DK0FR/rs485-protection-module/Mouser-Bestellliste-Rotor-Schutzmodul (1).xlsx

Sheet: Mouser
Mfr Part Number | Quantity | Manufacturer | Reference | Description | Nummer geprüft
2631803802 | 2 | Fair-Rite | FK1 | Ringkern Material 31, Ø 61 mm (FT240-31), außen auf der Steuerleitung; 1 Motorseite + 1 Stationsseite | nein
MF-R800 | 2 | Bourns | F1 | PTC-Sicherung, selbstrückstellend, 8 A halten / 16 A auslösen, 30 V, Raster 10,2 mm, 33 mm hoch; 1 Reserve | ja
B72214S0300K101 | 1 | TDK | RV1 | Varistor S14K30, 30 V AC / 38 V DC, bedrahtet | ja
2035-09-SM-RPLF | 1 | Bourns | GDT1 | Gasableiter 90 V, 2 Elektroden, 5 kA, SMD | ja
C1206C103KDRACTU | 8 | KEMET | C5–C10 | 10 nF, 1 kV, X7R, 1206; 2 Reserve | ja
744824801 | 1 | Würth Elektronik | L1 | Gleichtaktdrossel WE-CMB, 1 mH, 7,5 A, bedrahtet | ja
744842632 | 1 | Würth Elektronik | L2 | Gleichtaktdrossel WE-CMBNiZn, 32 µH, 5,5 A, bedrahtet | ja
SMCJ26A | 1 | Littelfuse | D1 | TVS 26 V, 1500 W, unidirektional, SMC | nein
EEU-FC1J101 | 1 | Panasonic | C1 | Elko 100 µF, 63 V, low ESR, bedrahtet | ja
C1206C104K1RACTU | 2 | KEMET | C2 | 100 nF, 100 V, X7R, 1206; 1 Reserve | nein
SMBJ15CA | 1 | Littelfuse | D3 | TVS 15 V, 600 W, bidirektional, SMB | nein
RC1206FR-071ML | 2 | Yageo | R4 | 1 MΩ, 1 %, 1206; 1 Reserve | nein
C1206C102JDGACTU | 6 | KEMET | C3, C4, C11, C12 | 1 nF, 1 kV, C0G, 5 %, 1206; 2 Reserve | ja
2036-09-SM-RPLF | 1 | Bourns | GDT2 | Gasableiter 90 V, 3 Elektroden, SMD | ja
CMB02070X1009JB200 | 4 | Vishay | R1, R2 | 10 Ω, Kohleschicht-MELF 0207, impulsfest; 2 Reserve | ja
744272222 | 1 | Würth Elektronik | L3 | Gleichtaktdrossel WE-SL5, 2,2 mH, 750 mA, SMD | ja
744227 | 1 | Würth Elektronik | L4 | Gleichtaktdrossel WE-SL2, 51 µH, SMD | ja
SM712.TCT | 2 | Semtech | D2 | TVS-Array RS485, 7 V / 12 V, SOT-23; 1 Reserve | ja
RC1206FR-07120RL | 2 | Yageo | R3 | 120 Ω, 1 %, 1206; 1 Reserve | nein
61300211121 | 1 | Würth Elektronik | JP1 | Stiftleiste 2-polig, Raster 2,54 mm | nein
60900213421 | 1 | Würth Elektronik | JP1 | Steckbrücke 2,54 mm | nein
1715721 | 3 | Phoenix Contact | J1, J2, J3 | Schraubklemme MKDS 1,5/2-5,08, 2-polig | nein
1715734 | 1 | Phoenix Contact | J4 | Schraubklemme MKDS 1,5/3-5,08, 3-polig | ja

Sheet: Hinweise
Bestellliste Rotor-Schutzmodul RS485 / 24 V, Rev. 4, Stand 11.10.2026
Blatt "Mouser": Spalte A = Hersteller-Bestellnummer, Spalte B = Menge. Diese beiden Spalten beim BOM-Import zuordnen.
Mengen: ein Modul, bei Kleinteilen mit Reserve (steht in der Beschreibung). FK1 zweimal: ein Ringkern am Motor, einer an der Station.
Nummer geprüft = ja: Bestellnummer am 08.10.2026 in einer Distributor-Liste gefunden. nein: aus dem Gedächtnis, nicht nachgeschlagen.
Lagerbestand, Preise und Mindestmengen bei Mouser wurden nicht geprüft.
Rev. 3: F1 ist jetzt eine selbstrückstellende PTC-Sicherung (Bourns MF-R800) statt Feinsicherung mit Halter.
Ersatz für C1206C102JDGACTU, falls nicht lieferbar: Yageo CC1206JKNPOCBN102 (1 nF, 1 kV, NP0, 5 %, 1206).
Rev. 4: Die Adapterplatine PA0086 entfällt, D2 sitzt direkt auf der Leiterplatte. Nicht in der Liste: Hirschmann CA 6 GD, Abstandshalter M3 x 5 mm, Leiterplatte.
C3 und C4 sind mit dem 1-kV-Typ von C11/C12 zusammengelegt, das spart eine Bestellposition.
