DK0FR/rs485-protection-module/doc/schaltplan.pdf

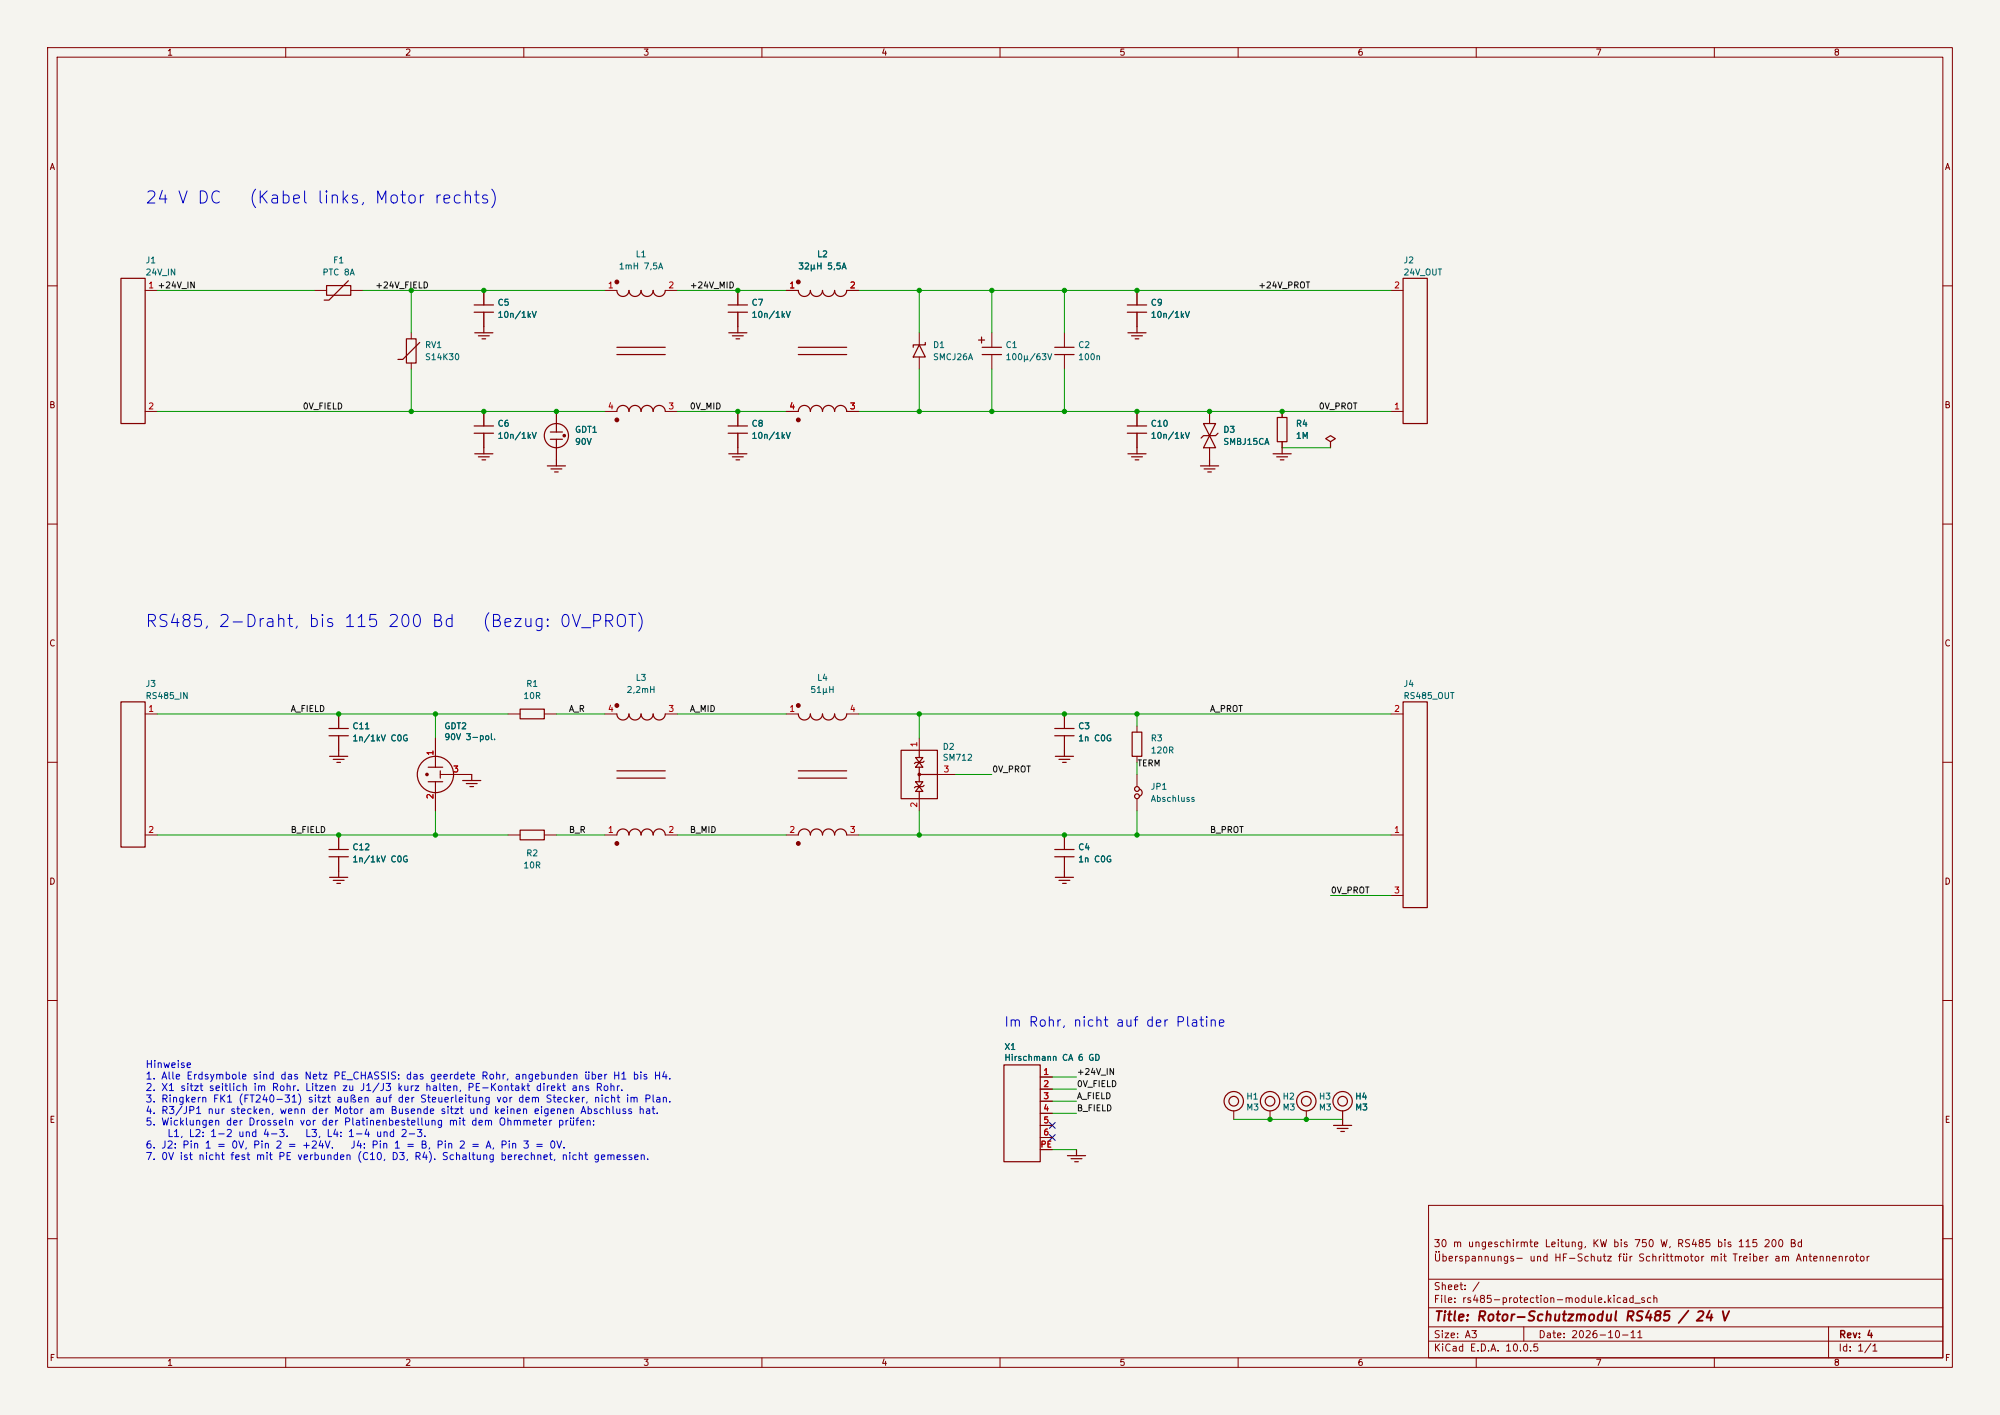
[picture p9: page 1]

Im Rohr, nicht auf der Platine

Hinweise
1. Alle Erdsymbole sind das Netz PE_CHASSIS: das geerdete Rohr, angebunden über H1 bis H4.
2. X1 sitzt seitlich im Rohr. Litzen zu J1/J3 kurz halten, PE-Kontakt direkt ans Rohr.
3. Ringkern FK1 (FT240-31) sitzt außen auf der Steuerleitung vor dem Stecker, nicht im Plan.
4. R3/JP1 nur stecken, wenn der Motor am Busende sitzt und keinen eigenen Abschluss hat.
5. Wicklungen der Drosseln vor der Platinenbestellung mit dem Ohmmeter prüfen:
7. 0V ist nicht fest mit PE verbunden (C10, D3, R4). Schaltung berechnet, nicht gemessen.

30 m ungeschirmte Leitung, KW bis 750 W, RS485 bis 115 200 Bd
Überspannungs- und HF-Schutz für Schrittmotor mit Treiber am Antennenrotor

Size: A3 | Rev: 4 | F Date: 2026-10-11
KiCad E.D.A. 10.0.5 | Id: 1/1
