DK0FR/rs485-protection-module/rs485-protection-module.kicad_pcb

## KiCad design rs485-protection-module.kicad_pcb (2026-10-15)

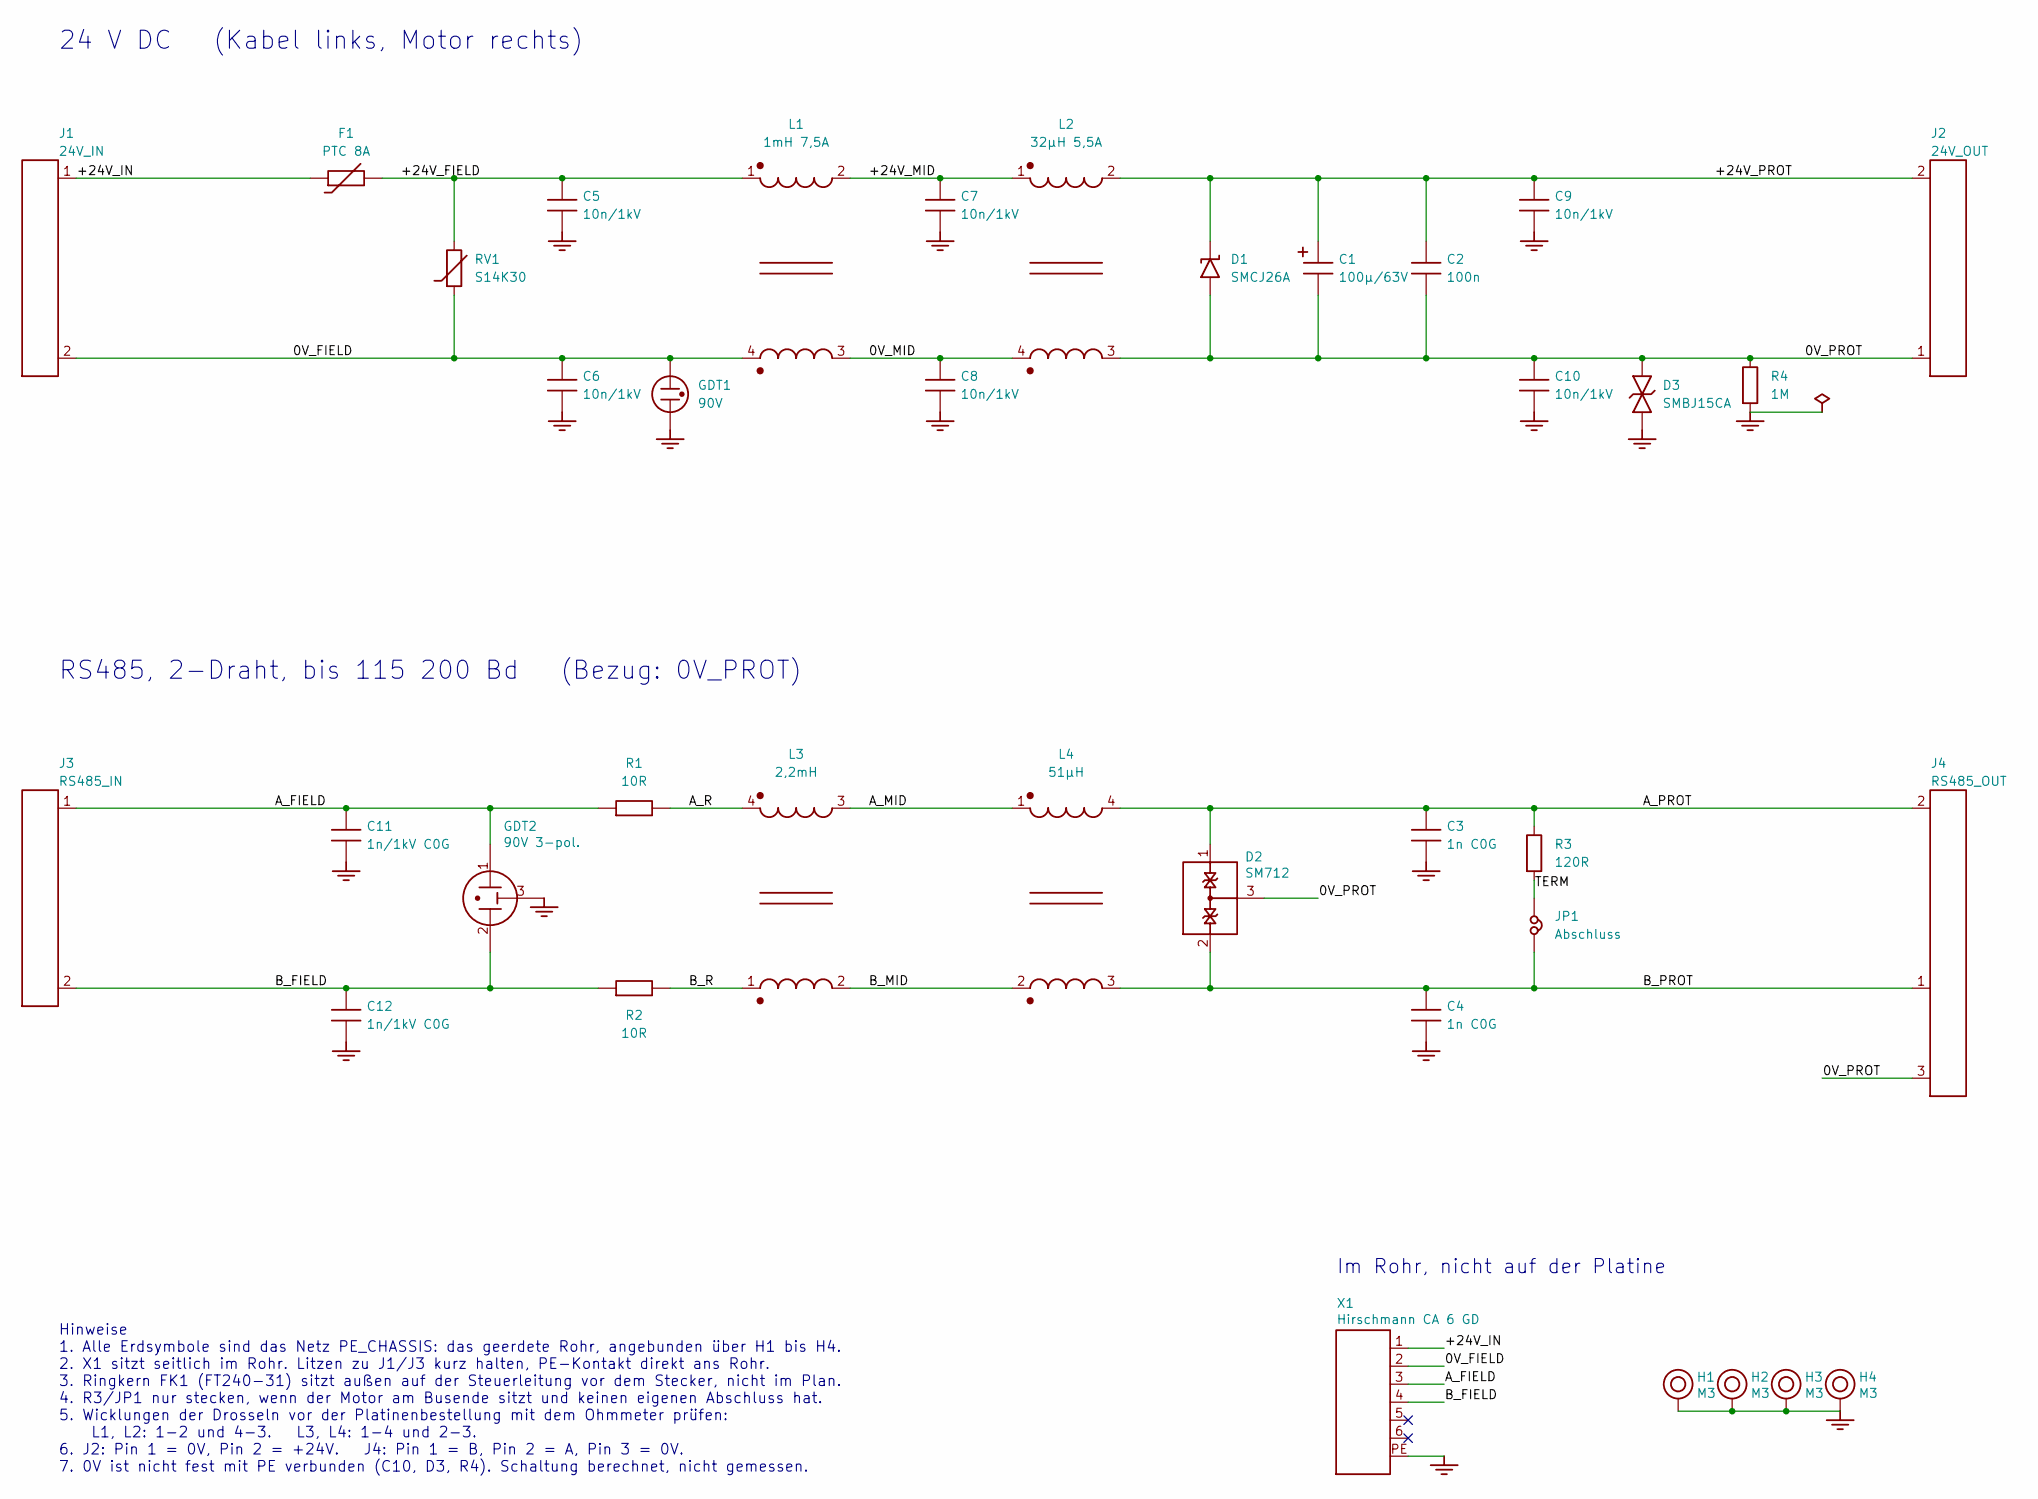
[picture p10: schematic rs485-protection-module.kicad_sch, Rotor-Schutzmodul RS485 / 24 V]

Parts:
C1: 100µ/63V; CP_Radial_D10.0mm_P5.00mm; MPN EEU-FC1J101
C2: 100n; C_1206_3216Metric_Pad1.33x1.80mm_HandSolder; MPN C1206C104K1RACTU
C3, C4: 1n C0G; C_1206_3216Metric_Pad1.33x1.80mm_HandSolder; MPN C1206C102JDGACTU
C5, C6, C7, C8, C9, C10: 10n/1kV; C_1206_3216Metric_Pad1.33x1.80mm_HandSolder; MPN C1206C103KDRACTU
C11, C12: 1n/1kV C0G; C_1206_3216Metric_Pad1.33x1.80mm_HandSolder; MPN C1206C102JDGACTU
D1: SMCJ26A; D_SMC_Handsoldering; MPN SMCJ26A
D2: SM712; SOT-23_Handsoldering; MPN SM712.TCT
D3: SMBJ15CA; D_SMB_Handsoldering; MPN SMBJ15CA
F1: PTC 8A; Fuse_PTC_Radial_P5.1mm_P10.2mm; MPN MF-R800
GDT1: 90V; GDT_Bourns_2035-xx-SM; MPN 2035-09-SM-RPLF
GDT2: 90V 3-pol.; GDT_Bourns_2036-xx-SM; MPN 2036-09-SM-RPLF
H1, H2, H3, H4: M3; MountingHole_3.2mm_M3_DIN965_Pad
J1: 24V_IN; TerminalBlock_Phoenix_MKDS-1,5-2-5.08_1x02_P5.08mm_Horizont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; MPN 1715721
J2: 24V_OUT; TerminalBlock_Phoenix_MKDS-1,5-2-5.08_1x02_P5.08mm_Horizont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; MPN 1715721
J3: RS485_IN; TerminalBlock_Phoenix_MKDS-1,5-2-5.08_1x02_P5.08mm_Horizont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; MPN 1715721
J4: RS485_OUT; TerminalBlock_Phoenix_MKDS-1,5-3-5.08_1x03_P5.08mm_Horizont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; MPN 1715734
JP1: Abschluss; PinHeader_1x02_P2.54mm_Vertical; MPN 60900213421
L1: 1mH 7,5A; L_CommonMode_Wuerth_WE-CMB-L_Pins1234; MPN 744824801
L2: 32µH 5,5A; L_CommonMode_Wuerth_WE-CMB-S; MPN 744842632
L3: 2,2mH; L_CommonModeChoke_Wuerth_WE-SL5; MPN 744272222
L4: 51µH; L_CommonMode_Wuerth_WE-SL2; MPN 744227
R1, R2: 10R; R_MELF_MMB-0207; MPN CMB02070X1009JB200
R3: 120R; R_1206_3216Metric_Pad1.30x1.75mm_HandSolder; MPN RC1206FR-07120RL
R4: 1M; R_1206_3216Metric_Pad1.30x1.75mm_HandSolder; MPN RC1206FR-071ML
RV1: S14K30; RV_Disc_D15.5mm_W4.5mm_P7.5mm; MPN B72214S0300K101
X1: Hirschmann CA 6 GD

Connections:
0V_FIELD: C6.1, GDT1.1, J1.2, L1.4, RV1.2, X1.2
0V_MID: C8.1, L1.3, L2.4
0V_PROT: C1.2, C2.2, C10.1, D1.2, D2.3, D3.1, J2.1, J4.3, L2.3, R4.1
+24V_FIELD: C5.1, F1.2, L1.1, RV1.1
+24V_IN: F1.1, J1.1, X1.1
+24V_MID: C7.1, L1.2, L2.1
+24V_PROT: C1.1, C2.1, C9.1, D1.1, J2.2, L2.2
A_FIELD: C11.1, GDT2.1, J3.1, R1.1, X1.3
A_MID: L3.3, L4.1
A_PROT: C3.1, D2.1, J4.2, L4.4, R3.1
A_R: L3.4, R1.2
B_FIELD: C12.1, GDT2.2, J3.2, R2.1, X1.4
B_MID: L3.2, L4.2
B_PROT: C4.1, D2.2, J4.1, JP1.2, L4.3
B_R: L3.1, R2.2
PE_CHASSIS: C3.2, C4.2, C5.2, C6.2, C7.2, C8.2, C9.2, C10.2, C11.2, C12.2, D3.2, GDT1.2, GDT2.3, H1.1, H2.1, H3.1, H4.1, R4.2, X1.PE
TERM: JP1.1, R3.2

Notes on the sheet:
Hinweise 1. Alle Erdsymbole sind das Netz PE_CHASSIS: das geerdete Rohr, angebunden über H1 bis H4. 2. X1 sitzt seitlich im Rohr. Litzen zu J1/J3 kurz halten, PE-Kontakt direkt ans Rohr. 3. Ringkern FK1 (FT240-31) sitzt außen auf der Steuerleitung vor dem Stecker, nicht im Plan. 4. R3/JP1 nur steck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
RS485, 2-Draht, bis 115 200 Bd (Bezug: 0V_PROT)
24 V DC (Kabel links, Motor rechts)
Im Rohr, nicht auf der Platine

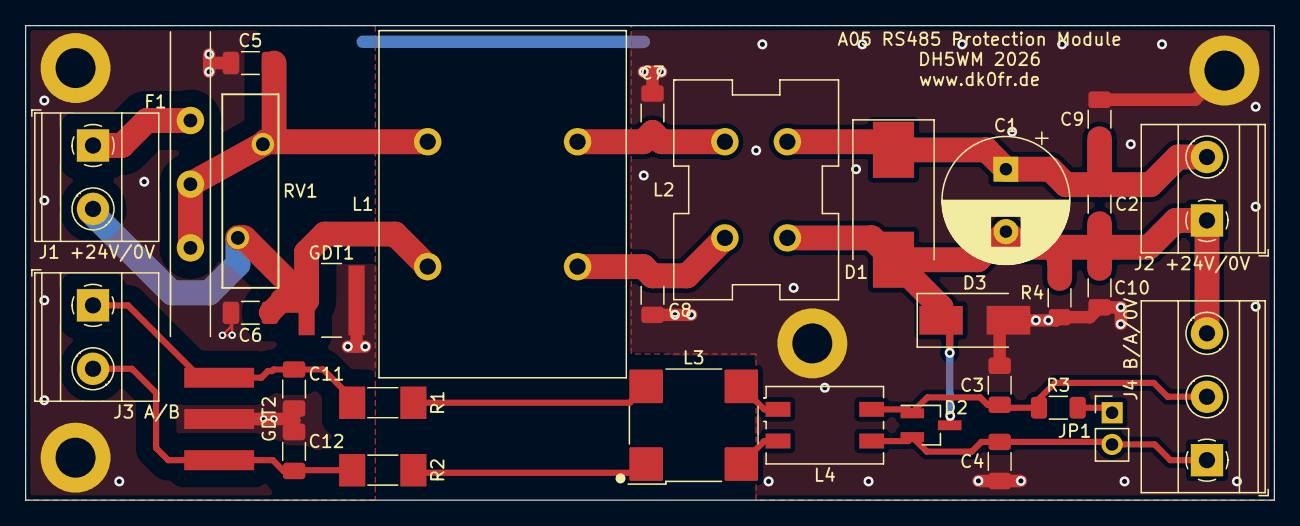
[picture p11: board rs485-protection-module.kicad_pcb from above]

Board: 2 copper layers, 100.0 x 38.0 mm, 36 parts (0 on the bottom side), 17 nets.
