DK0FR/rs485-protection-module/(commit log)

2026-10-15 RS485 Protection Module Rev. 4: geroutet, geprüft, Gerberdaten für JLCPCB
    Überspannungs- und HF-Schutzmodul für RS485 und 24 V am Antennenrotor
    (A05 RS485 Protection Module, DH5WM 2026, www.dk0fr.de).
    - KiCad-Projekt rs485-protection-module (Schaltplan, Layout 100 x 38 mm, 2 Lagen)
    - Geteilte PE-Flächen auf beiden Lagen, keine Kupferfläche unter L1/L3
    - Footprints gegen Datenblätter geprüft (RV1-, L1/L2-Bohrungen, GDT1-Pads,
    L3-Wicklungsbelegung korrigiert)
    - Überarbeiteter Bestückungsdruck mit Klemmen-Legenden
    - Gerber- und Bohrdaten für JLCPCB in Fertigung/JLCPCB_Rev4
    - Projektdokumentation rs485-protection-module.md, Mouser-Bestellliste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
    [Mouser-Bestellliste-Rotor-Schutzmodul (1).xlsx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]
2026-10-15 Projektdoku als README.md, Repository-Link ergänzt
    Die Zusammenfassung rs485-protection-module.md heißt jetzt README.md,
    damit GitHub sie auf der Startseite des Repositorys anzeigt. Oben
    stehen jetzt der Repository-Link und ein Link auf die Fertigungsdaten.
2026-10-15 README: Verbleib der früher offenen Punkte ergänzt
    Abgleich mit der Projektzusammenfassung aus der claude.ai-Sitzung (Stand
    vor dem Routing): Routing, Wicklungsprüfung, GDT-Lötflächen und das erste
    Öffnen in KiCad stehen jetzt mit ihrem Ergebnis im neuen Abschnitt
    "Erledigte Punkte", dazu eine optionale Ohmmeter-Prüfung von L3.
2026-10-15 Vollständige Dokumentation in doc/, README als Übersicht
    - doc/README.md: Aufgabe, technische Daten, Schaltung (24 V und RS485),
    Auslegung, Platine (Layout, PE-Konzept, Drosselwicklungen, Netzklassen,
    Bestückungsdruck), Einbau und Anschluss, Stückliste, Leiterplatten-
    bestellung, Bestückung, Prüfung und Inbetriebnahme, Prüfstand, offene
    Punkte, Dateien und Versionen
    - Abbildungen aus der Planung (Schaltbilder, Bestückungsplan, Einbau im
    Rohr) und neu aus KiCad: Lagenansichten oben/unten, 3D-Ansichten,
    Schaltplan als PDF
    - README.md im Hauptordner gekürzt auf Übersicht, Eckdaten und Verweise
    - .gitignore: doc/*.pdf zulassen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
